Gehtschon/Dynamic_soaring_Speed_Tracker/Hardware/PCB/ExpansionBoard/ExpansionBoard.kicad_pcb

## KiCad design Hardware/PCB/ExpansionBoard/ExpansionBoard.kicad_pcb (2025-01-01)

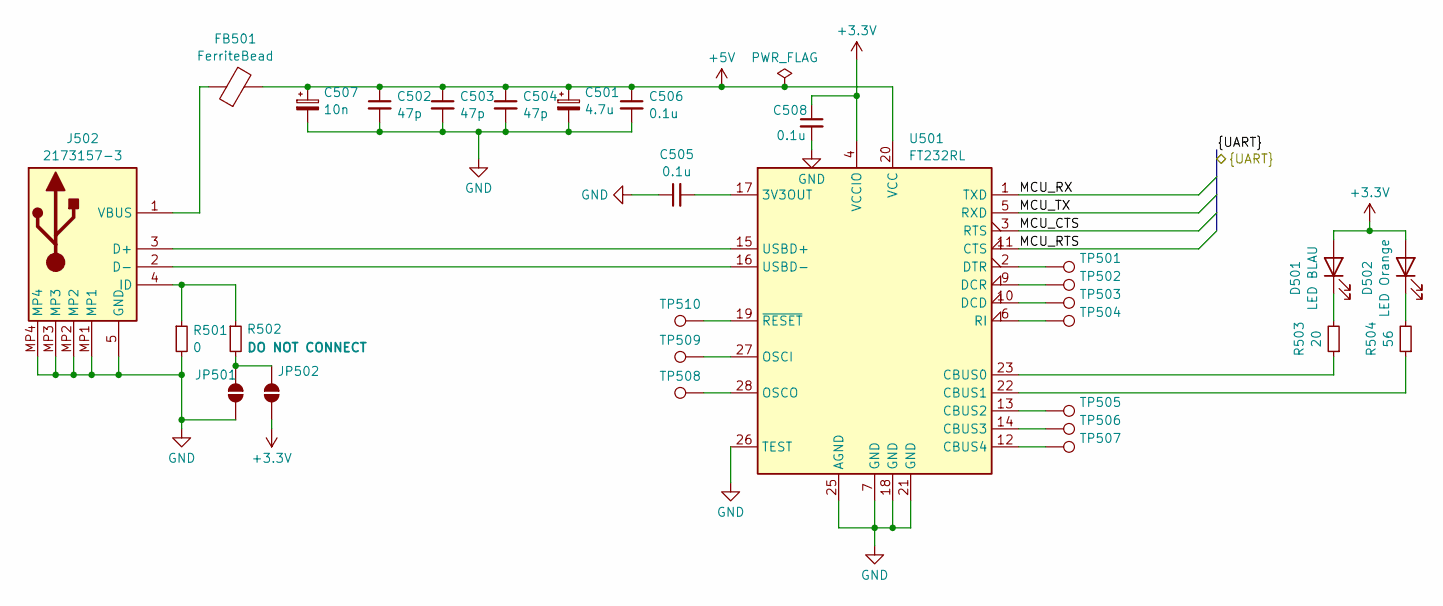
[picture p1: schematic UART_USB.kicad_sch]

Parts:
C501: 4.7u; C_0805_2012Metric_Pad1.18x1.45mm_HandSolder
C502, C503, C504: 47p; C_0805_2012Metric_Pad1.18x1.45mm_HandSolder
C505, C506, C508: 0.1u; C_0805_2012Metric_Pad1.18x1.45mm_HandSolder
C507: 10n; C_0805_2012Metric_Pad1.18x1.45mm_HandSolder
D501: LED BLAU; LEDM2012X100N
D502: LED Orange; R_0805_2012Metric
FB501: FerriteBead; C_0805_2012Metric_Pad1.18x1.45mm_HandSolder
J502: 2173157-3; 21731573; Mouser Part Number 571-2173157-3
JP501, JP502: SolderJumper_2_Open; SolderJumper-2_P1.3mm_Open_RoundedPad1.0x1.5mm
R501: 0; R_0805_2012Metric_Pad1.20x1.40mm_HandSolder
R502: DO NOT CONNECT; R_0805_2012Metric_Pad1.20x1.40mm_HandSolder
R503: 20; R_0805_2012Metric_Pad1.20x1.40mm_HandSolder
R504: 56; R_0805_2012Metric_Pad1.20x1.40mm_HandSolder
TP501, TP502, TP503, TP504, TP505, TP506, TP507, TP508, TP509, TP510: TestPoint; TestPoint_Pad_D1.5mm
U501: FT232RL; SSOP-28_5.3x10.2mm_P0.65mm

Connections:
+3.3V: C508.1, D501.2 (A), D502.2 (A), JP502.1 (A), U501.4 (VCCIO); also elsewhere on the board
+5V: C501.1, C502.1, C503.1, C504.1, C506.1, C507.1, FB501.2, U501.20 (VCC); also elsewhere on the board
/MCU Sheet/MCU_CTS: U501.3 (RTS); also elsewhere on the board
/MCU Sheet/MCU_RTS: U501.11 (CTS); also elsewhere on the board
/MCU Sheet/MCU_RX: U501.1 (TXD); also elsewhere on the board
/MCU Sheet/MCU_TX: U501.5 (RXD); also elsewhere on the board
GND: C501.2, C502.2, C503.2, C504.2, C505.1, C506.2, C507.2, C508.2, J502.5 (GND), J502.MP1, J502.MP2, J502.MP3, J502.MP4, JP501.1 (A), R501.2, U501.7 (GND), U501.18 (GND), U501.21 (GND), U501.25 (AGND), U501.26 (TEST); also elsewhere on the board
unnamed: D501.1 (K), R503.2
unnamed: D502.1 (K), R504.2
unnamed: J502.3 (D+), U501.15 (USBD+)
unnamed: J502.2 (D-), U501.16 (USBD-)
unnamed: J502.4 (ID), R501.1, R502.1
unnamed: FB501.1, J502.1 (VBUS)
unnamed: JP501.2 (B), JP502.2 (B), R502.2
unnamed: C505.2, U501.17 (3V3OUT)
unnamed: R503.1, U501.23 (CBUS0)
unnamed: R504.1, U501.22 (CBUS1)
unnamed: TP505.1, U501.13 (CBUS2)
unnamed: TP506.1, U501.14 (CBUS3)
unnamed: TP507.1, U501.12 (CBUS4)
unnamed: TP503.1, U501.10 (DCD)
unnamed: TP502.1, U501.9 (DCR)
unnamed: TP501.1, U501.2 (DTR)
unnamed: TP509.1, U501.27 (OSCI)
unnamed: TP508.1, U501.28 (OSCO)
unnamed: TP504.1, U501.6 (RI)
unnamed: TP510.1, U501.19 (~RESET)

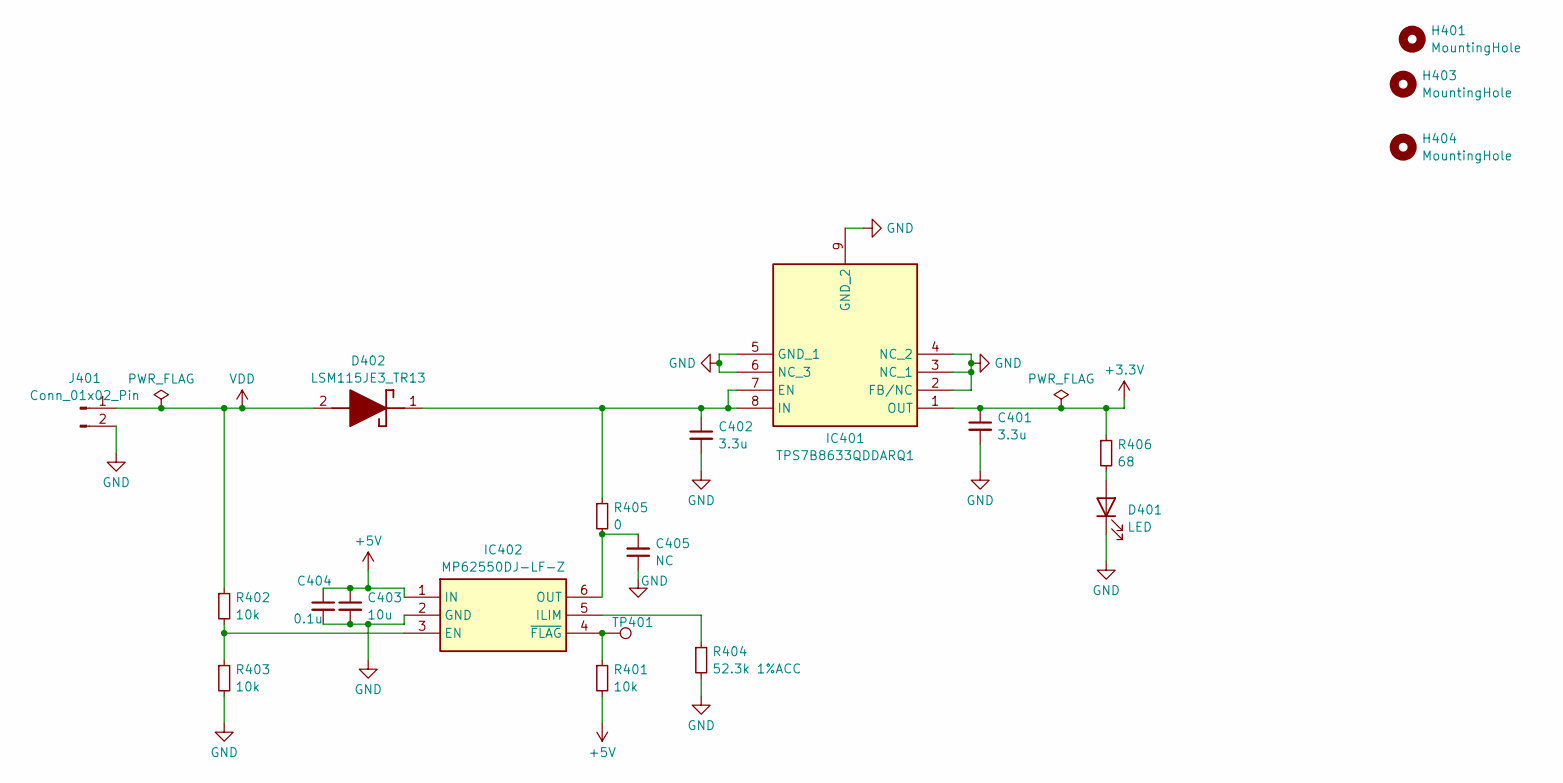
[picture p2: schematic Power.kicad_sch]

Parts:
C401, C402: 3.3u; C_0805_2012Metric_Pad1.18x1.45mm_HandSolder
C403: 10u; C_0805_2012Metric_Pad1.18x1.45mm_HandSolder
C404: 0.1u; C_0805_2012Metric_Pad1.18x1.45mm_HandSolder
C405: NC; C_0805_2012Metric_Pad1.18x1.45mm_HandSolder
D401: LED; LEDC2012X80N
D402: LSM115JE3_TR13; DIOM5436X330N; Mouser Part Number 494-LSM115JE3/TR13
H401, H403, H404: MountingHole; MountingHole_2.2mm_M2
IC401: TPS7B8633QDDARQ1; SOIC127P600X170-9N; Mouser Part Number 595-TPS7B8633QDDARQ1
IC402: MP62550DJ-LF-Z; SOT95P280X100-6N; Mouser Part Number 946-MP62550DJLFZ
J401: Conn_01x02_Pin; PinHeader_1x02_P2.54mm_Vertical
R401, R402, R403: 10k; R_0805_2012Metric_Pad1.20x1.40mm_HandSolder
R404: 52.3k 1%ACC; R_0805_2012Metric_Pad1.20x1.40mm_HandSolder
R405: 0; R_0805_2012Metric_Pad1.20x1.40mm_HandSolder
R406: 68; R_0805_2012Metric_Pad1.20x1.40mm_HandSolder
TP401: TestPoint; TestPoint_Pad_D1.5mm

Connections:
+3.3V: C401.1, IC401.1 (OUT), R406.1; also elsewhere on the board
+5V: C403.1, C404.1, IC402.1 (IN), R401.2; also elsewhere on the board
GND: C401.2, C402.2, C403.2, C404.2, C405.1, D401.1 (K), IC401.2 (FB/NC), IC401.3 (NC_1), IC401.4 (NC_2), IC401.5 (GND_1), IC401.6 (NC_3), IC401.9 (GND_2), IC402.2 (GND), J401.2, R403.2, R404.2; also elsewhere on the board
unnamed: D401.2 (A), R406.2
unnamed: C402.1, D402.1 (K), IC401.7 (EN), IC401.8 (IN), R405.1
unnamed: IC402.3 (EN), R402.2, R403.1
unnamed: IC402.5 (ILIM), R404.1
unnamed: C405.2, IC402.6 (OUT), R405.2
unnamed: IC402.4 (~FLAG), R401.1, TP401.1
VDD: D402.2 (A), J401.1, R402.1

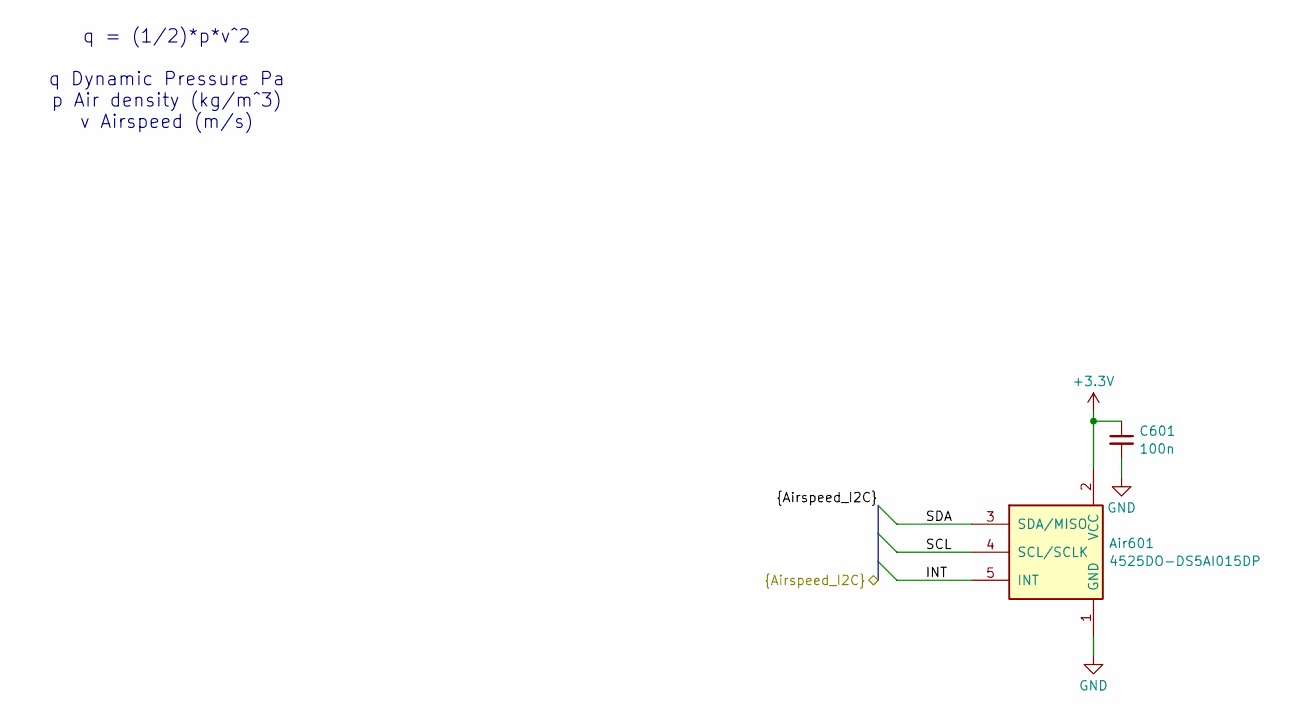
[picture p3: schematic Airspeed.kicad_sch]

Parts:
Air601: 4525DO-DS5AI015DP
C601: 100n; C_0805_2012Metric_Pad1.18x1.45mm_HandSolder

Connections:
+3.3V: Air601.2 (VCC), C601.1; also elsewhere on the board
/Airspeed Sheet/INT: Air601.5 (INT); also elsewhere on the board
/Airspeed Sheet/SCL: Air601.4 (SCL/SCLK); also elsewhere on the board
/Airspeed Sheet/SDA: Air601.3 (SDA/MISO); also elsewhere on the board
GND: Air601.1 (GND), C601.2; also elsewhere on the board

Notes on the sheet:
q = (1/2)*p*v^2 q Dynamic Pressure Pa p Air density (kg/m^3) v Airspeed (m/s)

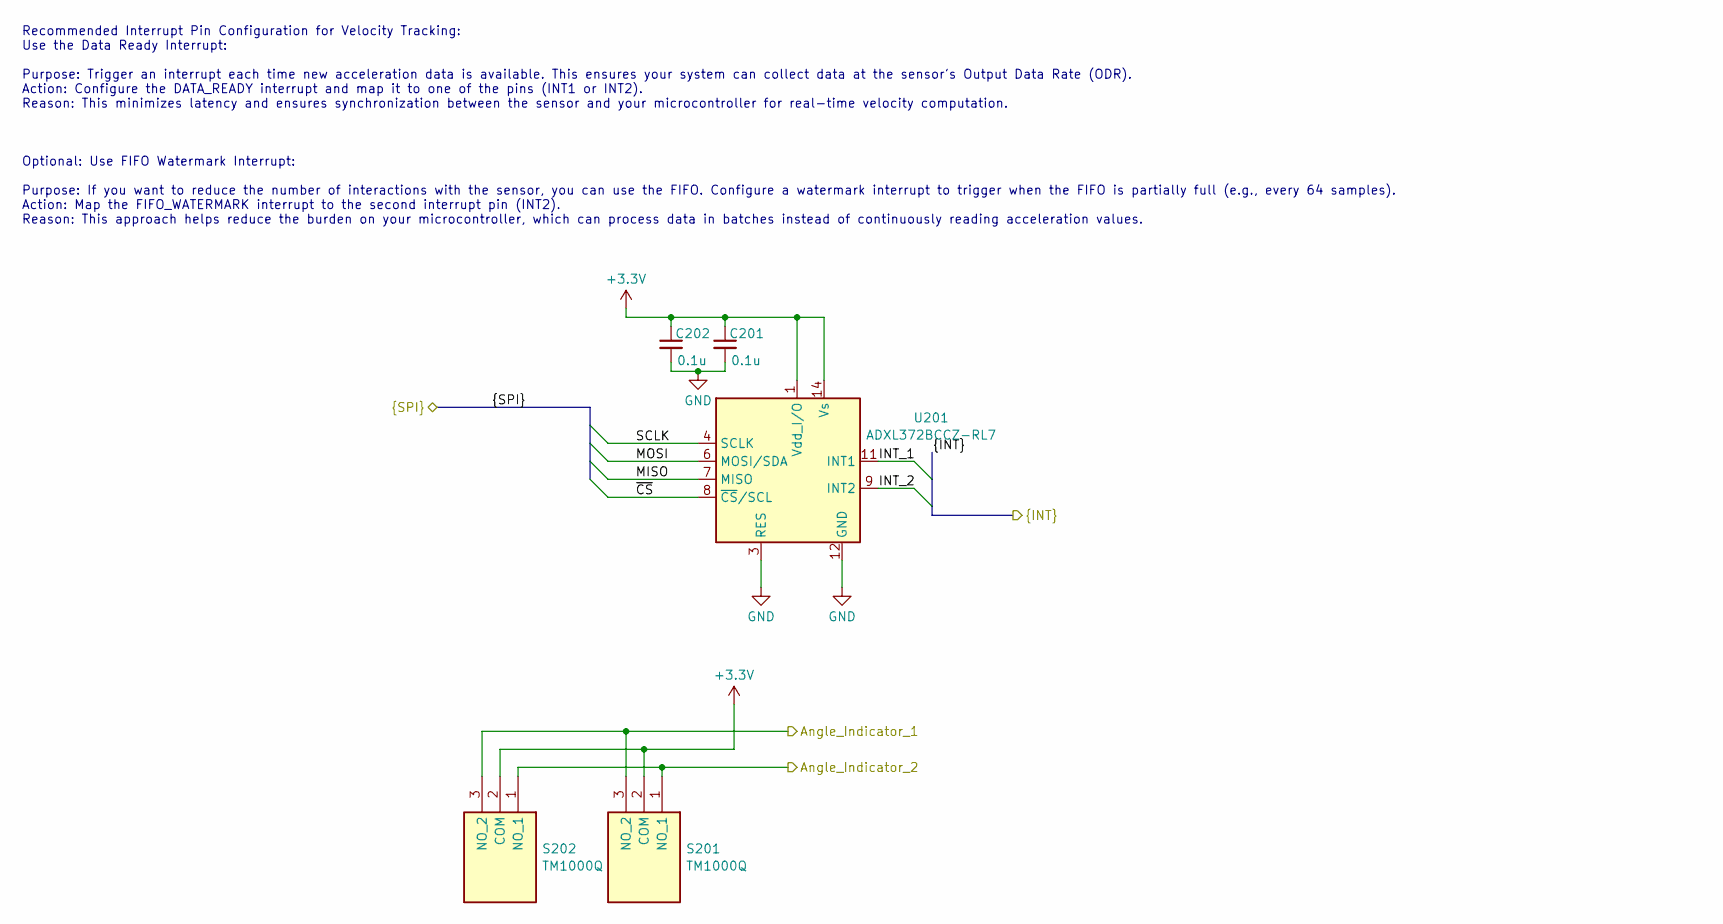
[picture p4: schematic Accelerometer.kicad_sch]

Parts:
C201, C202: 0.1u; C_0805_2012Metric_Pad1.18x1.45mm_HandSolder
S201, S202: TM1000Q; Mouser Part Number 612-TM1000Q
U201: ADXL372BCCZ-RL7

Connections:
+3.3V: C201.1, C202.1, S201.2 (COM), S202.2 (COM), U201.1 (Vdd_I/O), U201.14 (Vs); also elsewhere on the board
/Accelerometer.Sheet/Angle_Indicator_1: S201.3 (NO_2), S202.3 (NO_2); also elsewhere on the board
/Accelerometer.Sheet/Angle_Indicator_2: S201.1 (NO_1), S202.1 (NO_1); also elsewhere on the board
/Accelerometer.Sheet/INT_1: U201.11 (INT1); also elsewhere on the board
/Accelerometer.Sheet/INT_2: U201.9 (INT2); also elsewhere on the board
/Accelerometer.Sheet/MISO: U201.7 (MISO); also elsewhere on the board
/Accelerometer.Sheet/MOSI: U201.6 (MOSI/SDA); also elsewhere on the board
/Accelerometer.Sheet/SCLK: U201.4 (SCLK); also elsewhere on the board
/Accelerometer.Sheet/~CS: U201.8 (~CS/SCL); also elsewhere on the board
GND: C201.2, C202.2, U201.3 (RES), U201.5 (RES), U201.10 (RES), U201.12 (GND), U201.13 (GND), U201.16 (GND); also elsewhere on the board

Notes on the sheet:
Recommended Interrupt Pin Configuration for Velocity Tracking: Use the Data Ready Interrupt: Purpose: Trigger an interrupt each time new acceleration data is available. This ensures your system can collect data at the sensor's Output Data Rate (ODR). Action: Configure the DATA_READY interrupt and m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

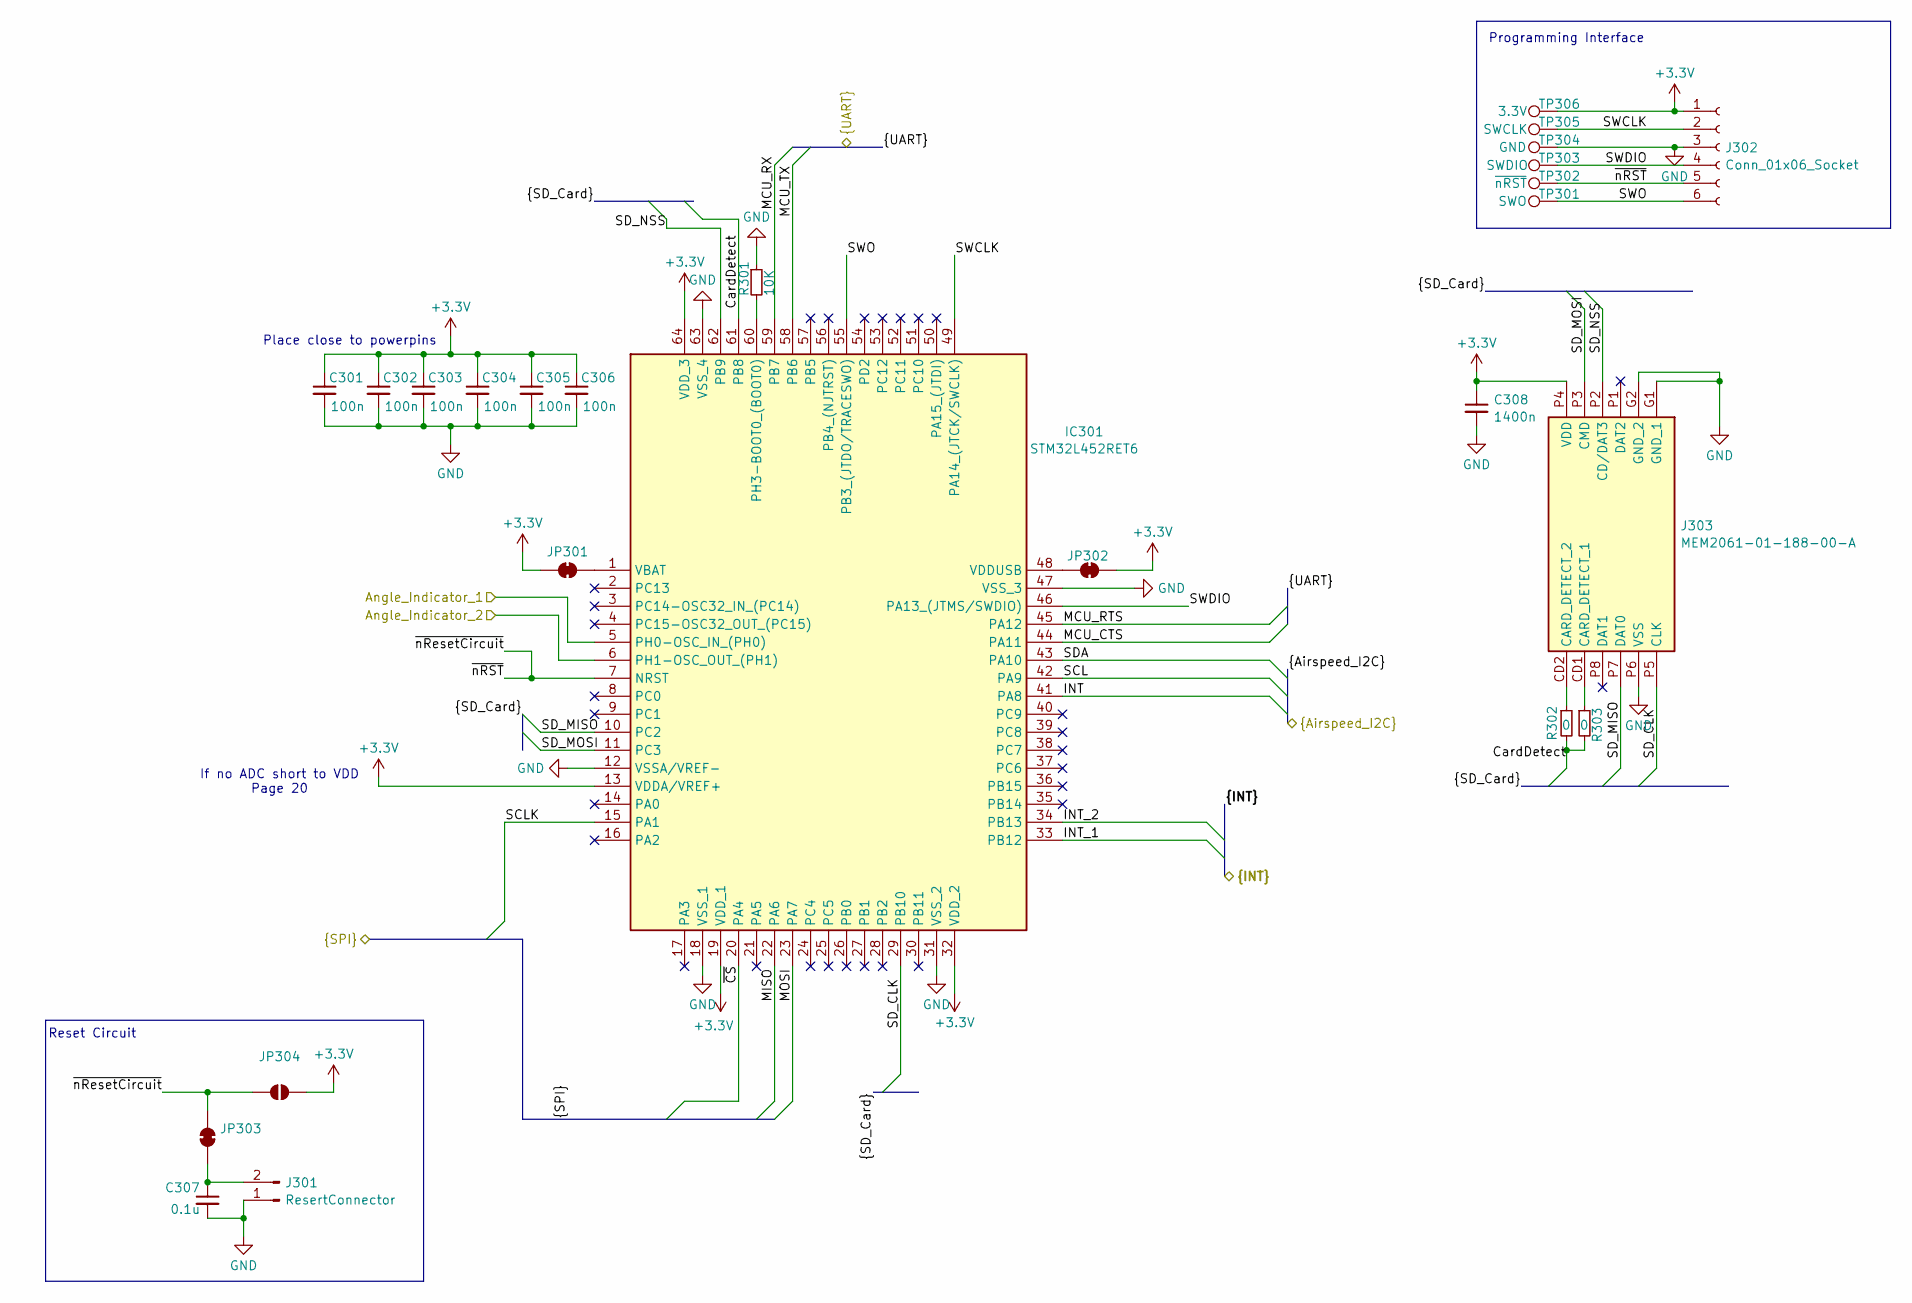
[picture p5: schematic MCU.kicad_sch]

Parts:
C301, C302, C303, C304, C305, C306: 100n; C_0805_2012Metric_Pad1.18x1.45mm_HandSolder
C307: 0.1u; C_0805_2012Metric_Pad1.18x1.45mm_HandSolder
C308: 1400n; C_0805_2012Metric_Pad1.18x1.45mm_HandSolder
IC301: STM32L452RET6; QFP50P1200X1200X160-64N; Mouser Part Number 511-STM32L452RET6
J301: ResertConnector; PinHeader_1x02_P2.54mm_Vertical
J302: Conn_01x06_Socket; Tag-Connect_TC2030-IDC-FP_2x03_P1.27mm_Vertical
J303: MEM2061-01-188-00-A; MEM20610118800A; Mouser Part Number 640-MEM20610118800A
JP301, JP302, JP303: SolderJumper_2_Bridged; SolderJumper-2_P1.3mm_Bridged_RoundedPad1.0x1.5mm
JP304: SolderJumper_2_Open; SolderJumper-2_P1.3mm_Open_RoundedPad1.0x1.5mm
R301: 10K; R_0805_2012Metric_Pad1.20x1.40mm_HandSolder
R302, R303: 0; R_0805_2012Metric_Pad1.20x1.40mm_HandSolder
TP301: SWO; TestPoint_Pad_D1.5mm
TP302: ~{nRST}; TestPoint_Pad_D1.5mm
TP303: SWDIO; TestPoint_Pad_D1.5mm
TP304: GND; TestPoint_Pad_D1.5mm
TP305: SWCLK; TestPoint_Pad_D1.5mm
TP306: 3.3V; TestPoint_Pad_D1.5mm

Connections:
+3.3V: C301.1, C302.1, C303.1, C304.1, C305.1, C306.1, C308.1, IC301.13 (VDDA/VREF+), IC301.19 (VDD_1), IC301.32 (VDD_2), IC301.64 (VDD_3), J302.1, J303.P4 (VDD), JP301.1 (A), JP302.1 (A), JP304.2 (B), TP306.1; also elsewhere on the board
/Accelerometer.Sheet/Angle_Indicator_1: IC301.5 (PH0-OSC_IN_(PH0)); also elsewhere on the board
/Accelerometer.Sheet/Angle_Indicator_2: IC301.6 (PH1-OSC_OUT_(PH1)); also elsewhere on the board
/Accelerometer.Sheet/INT_1: IC301.33 (PB12); also elsewhere on the board
/Accelerometer.Sheet/INT_2: IC301.34 (PB13); also elsewhere on the board
/Accelerometer.Sheet/MISO: IC301.22 (PA6); also elsewhere on the board
/Accelerometer.Sheet/MOSI: IC301.23 (PA7); also elsewhere on the board
/Accelerometer.Sheet/SCLK: IC301.15 (PA1); also elsewhere on the board
/Accelerometer.Sheet/~CS: IC301.20 (PA4); also elsewhere on the board
/Airspeed Sheet/INT: IC301.41 (PA8); also elsewhere on the board
/Airspeed Sheet/SCL: IC301.42 (PA9); also elsewhere on the board
/Airspeed Sheet/SDA: IC301.43 (PA10); also elsewhere on the board
/MCU Sheet/CardDetect: IC301.61 (PB8), R302.2, R303.2
/MCU Sheet/MCU_CTS: IC301.44 (PA11); also elsewhere on the board
/MCU Sheet/MCU_RTS: IC301.45 (PA12); also elsewhere on the board
/MCU Sheet/MCU_RX: IC301.59 (PB7); also elsewhere on the board
/MCU Sheet/MCU_TX: IC301.58 (PB6); also elsewhere on the board
/MCU Sheet/SD_CLK: IC301.29 (PB10), J303.P5 (CLK)
/MCU Sheet/SD_MISO: IC301.10 (PC2), J303.P7 (DAT0)
/MCU Sheet/SD_MOSI: IC301.11 (PC3), J303.P3 (CMD)
/MCU Sheet/SD_NSS: IC301.62 (PB9), J303.P2 (CD/DAT3)
/MCU Sheet/SWCLK: IC301.49 (PA14_(JTCK/SWCLK)), J302.2, TP305.1
/MCU Sheet/SWDIO: IC301.46 (PA13_(JTMS/SWDIO)), J302.4, TP303.1
/MCU Sheet/SWO: IC301.55 (PB3_(JTDO/TRACESWO)), J302.6, TP301.1
/MCU Sheet/~nRST: IC301.7 (NRST), J302.5, JP303.2 (B), JP304.1 (A), TP302.1
GND: C301.2, C302.2, C303.2, C304.2, C305.2, C306.2, C307.2, C308.2, IC301.12 (VSSA/VREF-), IC301.18 (VSS_1), IC301.31 (VSS_2), IC301.47 (VSS_3), IC301.63 (VSS_4), J301.1, J302.3, J303.G1 (GND_1), J303.G2 (GND_2), J303.P6 (VSS), R301.1, TP304.1; also elsewhere on the board
unnamed: IC301.60 (PH3-BOOT0_(BOOT0)), R301.2
unnamed: IC301.1 (VBAT), JP301.2 (B)
unnamed: IC301.48 (VDDUSB), JP302.2 (B)
unnamed: C307.1, J301.2, JP303.1 (A)
unnamed: J303.CD1 (CARD_DETECT_1), R303.1
unnamed: J303.CD2 (CARD_DETECT_2), R302.1

Notes on the sheet:
Programming Interface
If no ADC short to VDD Page 20
Reset Circuit
Place close to powerpins

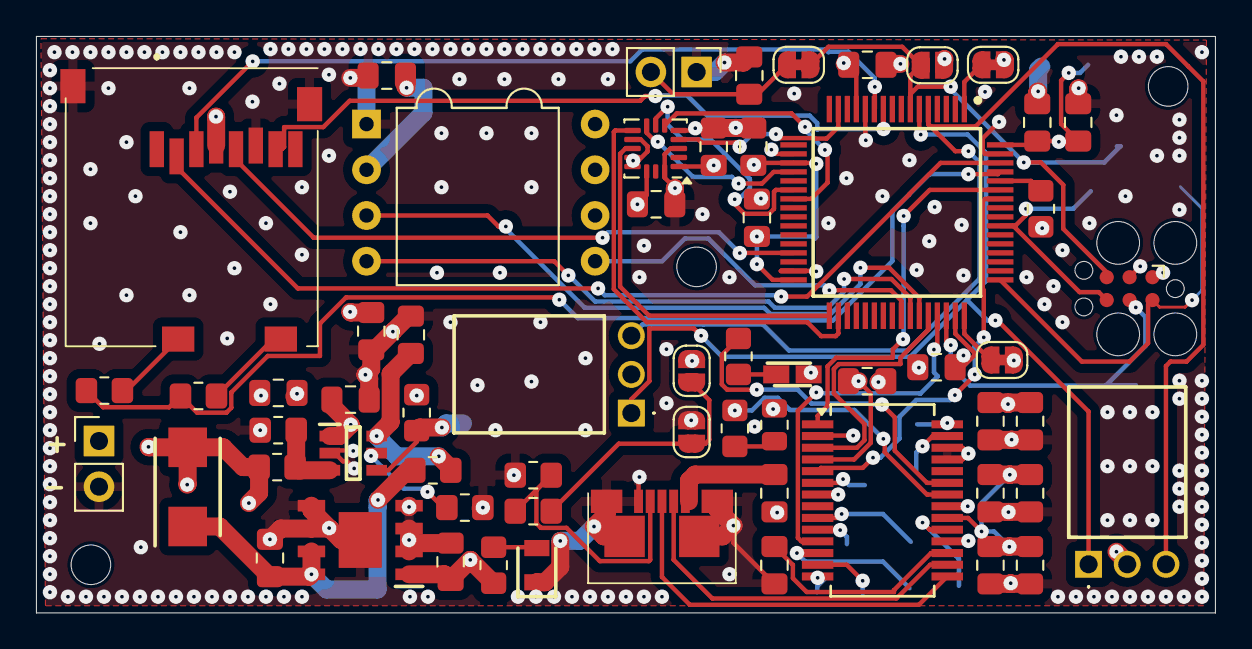
[picture p6: board ExpansionBoard.kicad_pcb from above]

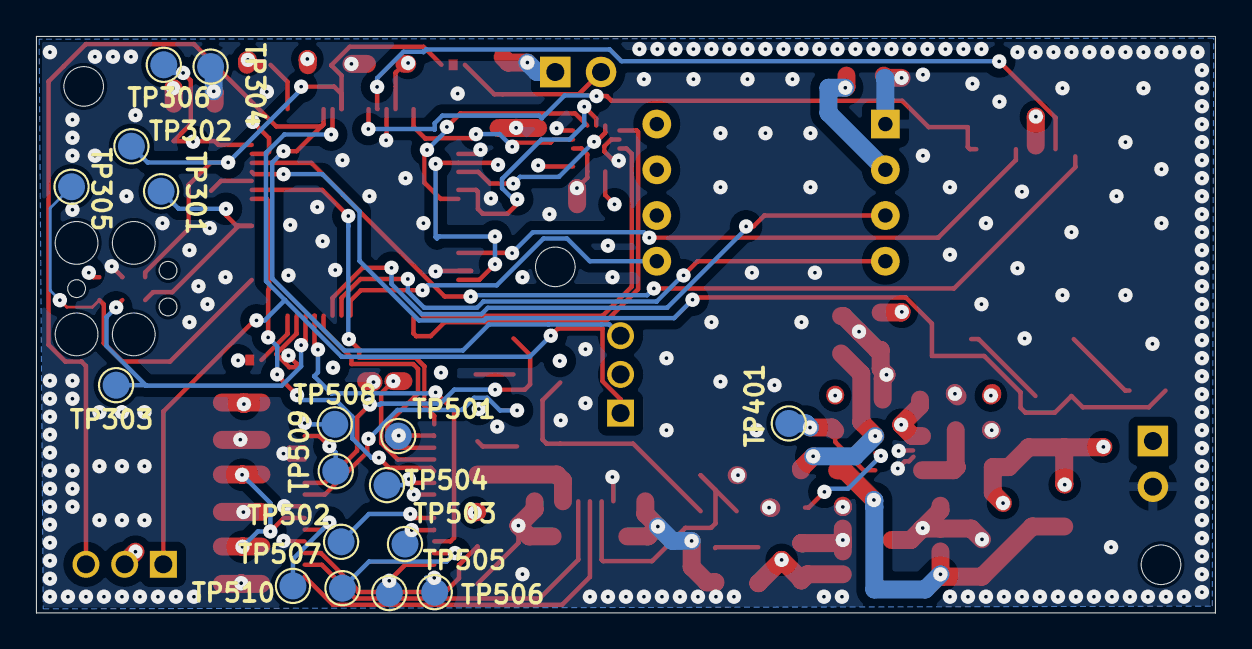
[picture p7: board ExpansionBoard.kicad_pcb from below]

Board: 4 copper layers, 65.5 x 32.0 mm, 81 parts (17 on the bottom side), 60 nets.
