Gehtschon/Dynamic_soaring_Speed_Tracker/(threads)

Thread 1 (2024-12-22):

OPTIONAL: FT232 Reset to VCC

Gehtschon, 2024-12-22:
Make connection to VCC with solder bridge
