Gehtschon/Dynamic_soaring_Speed_Tracker/Software/DynamicSoaring/DynamicSoaring.ioc

Mcu.UserName=STM32L452RETx
PA1.Signal=SPI1_SCK
PA10.Signal=I2C1_SDA
PA11.Signal=USART1_CTS
PA12.Signal=USART1_RTS
PA4.Signal=SPI1_NSS
PA6.Signal=SPI1_MISO
PA7.Signal=SPI1_MOSI
PA8.Signal=GPXTI8
PA9.Signal=I2C1_SCL
PB10.Signal=SPI2_SCK
PB12.GPIO_Label=ACC_INT_1
PB12.Signal=GPXTI12
PB13.GPIO_Label=ACC_INT_2
PB13.Signal=GPXTI13
PB6.Signal=USART1_TX
PB7.Signal=USART1_RX
PB8.GPIO_Label=SD_CD
PB8.Signal=GPIO_Output
PB9.Signal=SPI2_NSS
PC2.Signal=SPI2_MISO
PC3.Signal=SPI2_MOSI
