Gehtschon/Dynamic_soaring_Speed_Tracker/(commit log)

2024-12-01 ACC Sheet almost finshied added SPI BUS
    [Accelerometer.kicad_sch, ExpansionBoard.kicad_pcb, ExpansionBoard.kicad_sch, MCU.kicad_sch]
2024-12-02 INT BUS
    [Accelerometer.kicad_sch, ExpansionBoard.kicad_sch, MCU.kicad_sch]
2024-12-03 added POWER Sheet
    [Accelerometer.kicad_sch, ExpansionBoard.kicad_sch, Power.kicad_sch]
2024-12-06 added PINOUT to mcu and UART USB CHIP
    [ExpansionBoard.kicad_sch, MCU.kicad_sch, UART_USB.kicad_sch]
2024-12-07 added USB and Powerseitcher
    [MCU.kicad_sch, Power.kicad_sch, UART_USB.kicad_sch]
2024-12-08 DONE: PWR LED MISSING AND AIRSPEED
    [Accelerometer.kicad_sch, ExpansionBoard.kicad_sch, MCU.kicad_sch, Power.kicad_sch, UART_USB.kicad_sch]
2024-12-11 added Airspeed simulation and Footprint with 3D model
    [Accelerometer.kicad_sch, Airspeed.kicad_sch, ExpansionBoard.kicad_sch, MCU.kicad_sch]
2024-12-15 finished schema
    [Accelerometer.kicad_sch, Airspeed.kicad_sch, ExpansionBoard.kicad_sch, MCU.kicad_sch, Power.kicad_sch, UART_USB.kicad_sch]
2024-12-15 to pcb
    [ExpansionBoard.kicad_pcb, MCU.kicad_sch, Power.kicad_sch, UART_USB.kicad_sch]
2024-12-16 added Cube Project, SD Card and Tillt Switch
    [Accelerometer.kicad_sch, ExpansionBoard.kicad_pcb, ExpansionBoard.kicad_sch, MCU.kicad_sch]
2024-12-19 finished pcb layout
    [Accelerometer.kicad_sch, ExpansionBoard.kicad_pcb, MCU.kicad_sch, Power.kicad_sch, UART_USB.kicad_sch]
2024-12-20 finsihed filling
    [ExpansionBoard.kicad_pcb]
2024-12-20 finsihed pcb
    [Accelerometer.kicad_sch, ExpansionBoard.kicad_pcb, MCU.kicad_sch, Power.kicad_sch, UART_USB.kicad_sch]
2025-01-01 removed error in drc
    [ExpansionBoard.kicad_pcb]
2025-01-15 added boomm
    [bom.csv, designators.csv, positions.csv]
